RetroCoreLabs/HDLCGW/kicad/HDLC-ESP32-S2/db25-footprint-check.pdf

## DB-25 male, right-angle: footprint check sheet (KiCad 9.0 stock footprints)

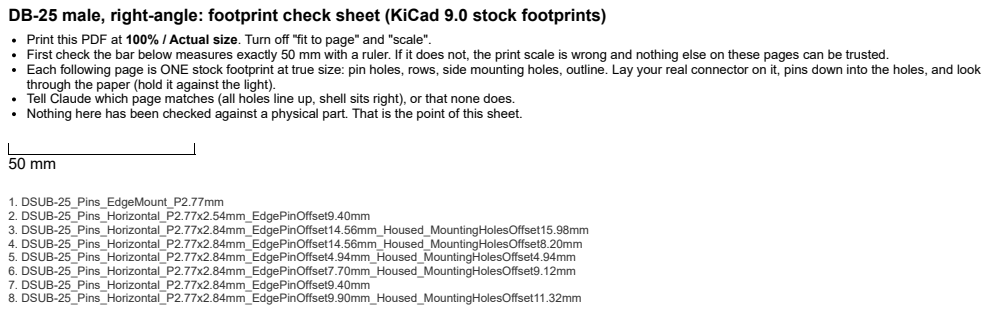
[picture p1: page 1]
1. DSUB-25_Pins_EdgeMount_P2.77mm 2. DSUB-25_Pins_Horizontal_P2.77x2.54mm_EdgePinOffset9.40mm 3. DSUB-25_Pins_Horizontal_P2.77x2.84mm_EdgePinOffset14.56mm_Housed_MountingHolesOffset15.98mm 4. DSUB-25_Pins_Horizontal_P2.77x2.84mm_EdgePinOffset14.56mm_Housed_MountingHolesOffset8.20mm 5. DSUB-25_Pins_Horizontal_P2.77x2.84mm_EdgePinOffset4.94mm_Housed_MountingHolesOffset4.94mm 6. DSUB-25_Pins_Horizontal_P2.77x2.84mm_EdgePinOffset7.70mm_Housed_MountingHolesOffset9.12mm 7. DSUB-25_Pins_Horizontal_P2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

Print this PDF at 100% / Actual size. Turn off "fit to page" and "scale".
First check the bar below measures exactly 50 mm with a ruler. If it does not, the print scale is wrong and nothing else on these pages can be trusted.
Each following page is ONE stock footprint at true size: pin holes, rows, side mounting holes, outline. Lay your real connector on it, pins down into the holes, and look
through the paper (hold it against the light).
Tell Claude which page matches (all holes line up, shell sits right), or that none does.
Nothing here has been checked against a physical part. That is the point of this sheet.

## 1/8 DSUB-25_Pins_EdgeMount_P2.77mm

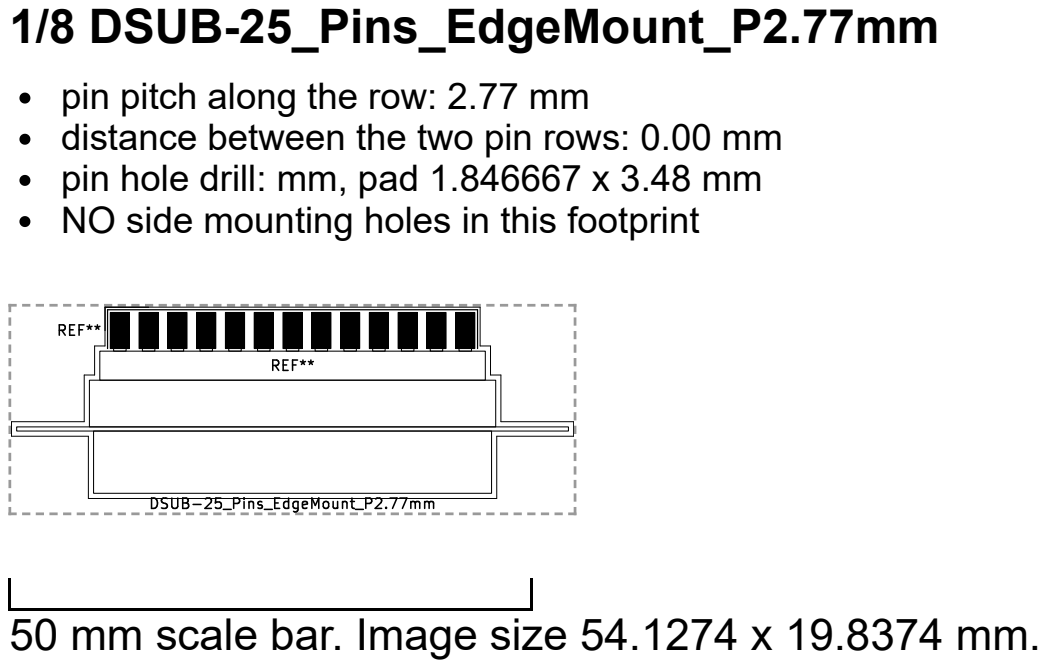
[picture p2: page 2]

pin pitch along the row: 2.77 mm
distance between the two pin rows: 0.00 mm
pin hole drill: mm, pad 1.846667 x 3.48 mm
NO side mounting holes in this footprint

50 mm scale bar. Image size 54.1274 x 19.8374 mm.

## 2/8 DSUB-25_Pins_Horizontal_P2.77x2.54mm_EdgePinOffset9.40mm

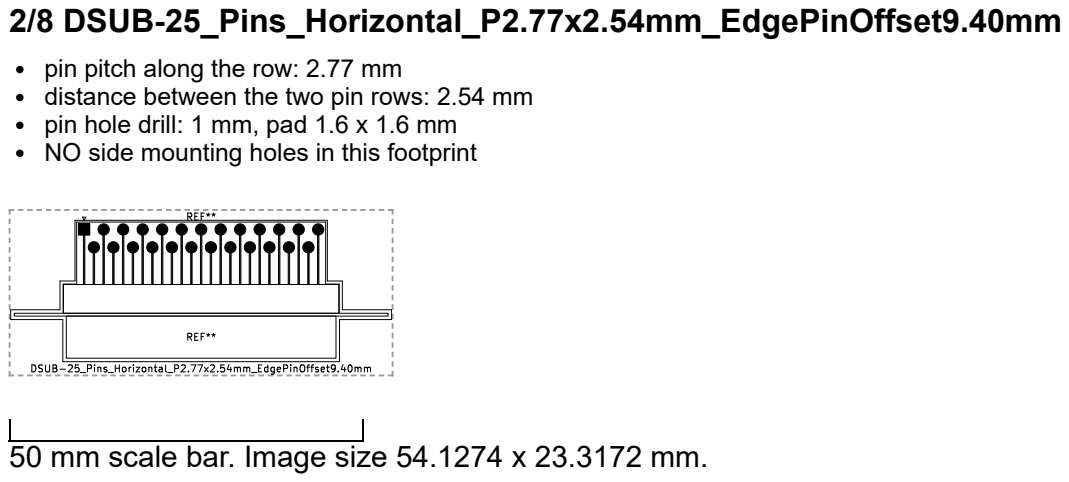
[picture p3: page 3]

pin pitch along the row: 2.77 mm
distance between the two pin rows: 2.54 mm
pin hole drill: 1 mm, pad 1.6 x 1.6 mm
NO side mounting holes in this footprint

50 mm scale bar. Image size 54.1274 x 23.3172 mm.

3/8 DSUB-25_Pins_Horizontal_P2.77x2.84mm_EdgePinOffset14.56mm_Housed_MountingHolesOffset15.98mm

pin pitch along the row: 2.77 mm
distance between the two pin rows: 2.84 mm
pin hole drill: 1 mm, pad 1.6 x 1.6 mm
side mounting holes: 2 holes, centre-to-centre 47.10 mm, drill 3.2 mm, pad 4.0 x 4.0 mm, type thru_hole mounting hole centres sit 1.42 mm from pin row 1 (across the rows)

50 mm scale bar. Image size 78.9432 x 29.7942 mm.

4/8 DSUB-25_Pins_Horizontal_P2.77x2.84mm_EdgePinOffset14.56mm_Housed_MountingHolesOffset8.20mm

pin pitch along the row: 2.77 mm
distance between the two pin rows: 2.84 mm
pin hole drill: 1 mm, pad 1.6 x 1.6 mm
side mounting holes: 2 holes, centre-to-centre 47.10 mm, drill 3.2 mm, pad 4.0 x 4.0 mm, type thru_hole mounting hole centres sit 9.20 mm from pin row 1 (across the rows)

50 mm scale bar. Image size 78.0034 x 29.7942 mm.

5/8 DSUB-25_Pins_Horizontal_P2.77x2.84mm_EdgePinOffset4.94mm_Housed_MountingHolesOffset4.94mm

pin pitch along the row: 2.77 mm
distance between the two pin rows: 2.84 mm
pin hole drill: 1 mm, pad 1.6 x 1.6 mm
side mounting holes: 2 holes, centre-to-centre 47.10 mm, drill 3.2 mm, pad 4.0 x 4.0 mm, type thru_hole mounting hole centres sit 2.84 mm from pin row 1 (across the rows)

50 mm scale bar. Image size 77.0382 x 20.1676 mm.

6/8 DSUB-25_Pins_Horizontal_P2.77x2.84mm_EdgePinOffset7.70mm_Housed_MountingHolesOffset9.12mm

pin pitch along the row: 2.77 mm
distance between the two pin rows: 2.84 mm
pin hole drill: 1 mm, pad 1.6 x 1.6 mm
side mounting holes: 2 holes, centre-to-centre 47.10 mm, drill 3.2 mm, pad 4.0 x 4.0 mm, type thru_hole mounting hole centres sit 1.42 mm from pin row 1 (across the rows)

50 mm scale bar. Image size 77.0382 x 22.9362 mm.

## 7/8 DSUB-25_Pins_Horizontal_P2.77x2.84mm_EdgePinOffset9.40mm

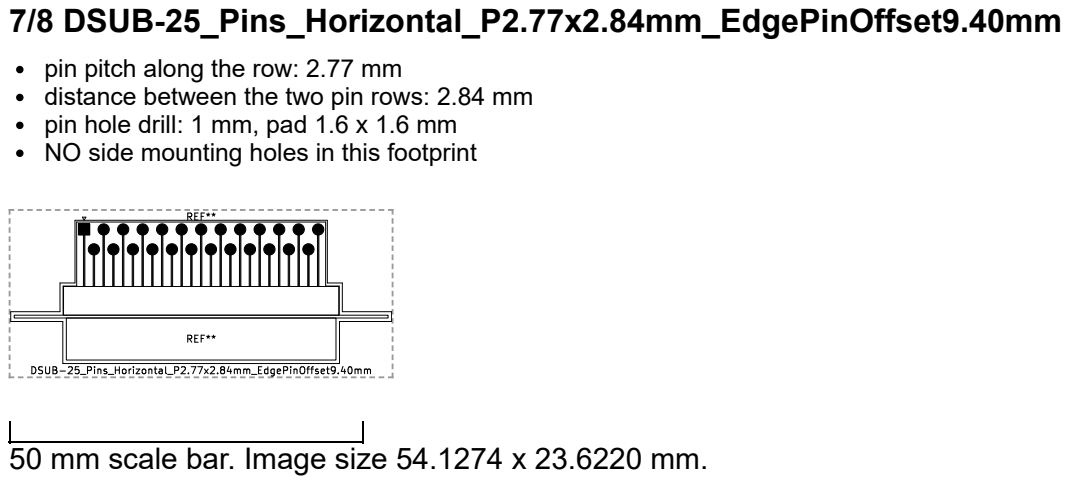
[picture p4: page 8]

pin pitch along the row: 2.77 mm
distance between the two pin rows: 2.84 mm
pin hole drill: 1 mm, pad 1.6 x 1.6 mm
NO side mounting holes in this footprint

50 mm scale bar. Image size 54.1274 x 23.6220 mm.

8/8 DSUB-25_Pins_Horizontal_P2.77x2.84mm_EdgePinOffset9.90mm_Housed_MountingHolesOffset11.32mm

pin pitch along the row: 2.77 mm
distance between the two pin rows: 2.84 mm
pin hole drill: 1 mm, pad 1.6 x 1.6 mm
side mounting holes: 2 holes, centre-to-centre 47.10 mm, drill 3.2 mm, pad 4.0 x 4.0 mm, type thru_hole mounting hole centres sit 1.42 mm from pin row 1 (across the rows)

50 mm scale bar. Image size 78.0034 x 25.1206 mm.
