RetroCoreLabs/HDLCGW/kicad/HDLC-ESP32-S2/wemos-s2-mini-footprint-check.pdf

## WEMOS S2 mini - footprint at 1:1 (print at 100 percent, NOT "fit to page")

Check first: the bar below must measure exactly 50 mm with a ruler. If not, the printer is scaling.

Hold your real board on top of the print and look through the paper. Which end the USB connector is at is NOT verified here: turn the board until the pin holes line up, then tell me which end the USB is at. Each round pad must sit over a pin hole of the board. Pad rows: A and B are the left two columns, C and D the right two columns; pad 1 of each column is at the top.
Pad centres (mm): column A x=0, B x=2.54, C x=20.32, D x=22.86. Row pitch 2.54, 8 rows (y=0 to 17.78). Pad 1 of column A is square.

Outline = board edge from the KiCad C3 mini footprint (about 25.7 x 34.6 mm). This is NOT yet confirmed against your board: that is what this sheet is for. Source: kicad/HDLC-ESP32-S2/HDLC-ESP32-S2.pretty/WEMOS_S2_mini.kicad_mod

50 mm
