RetroCoreLabs/HDLCGW/kicad/HDLC-ESP32-S2/HDLC-ESP32-S2.kicad_sch

## KiCad design kicad/HDLC-ESP32-S2/HDLC-ESP32-S2.kicad_sch (2026-11-12)

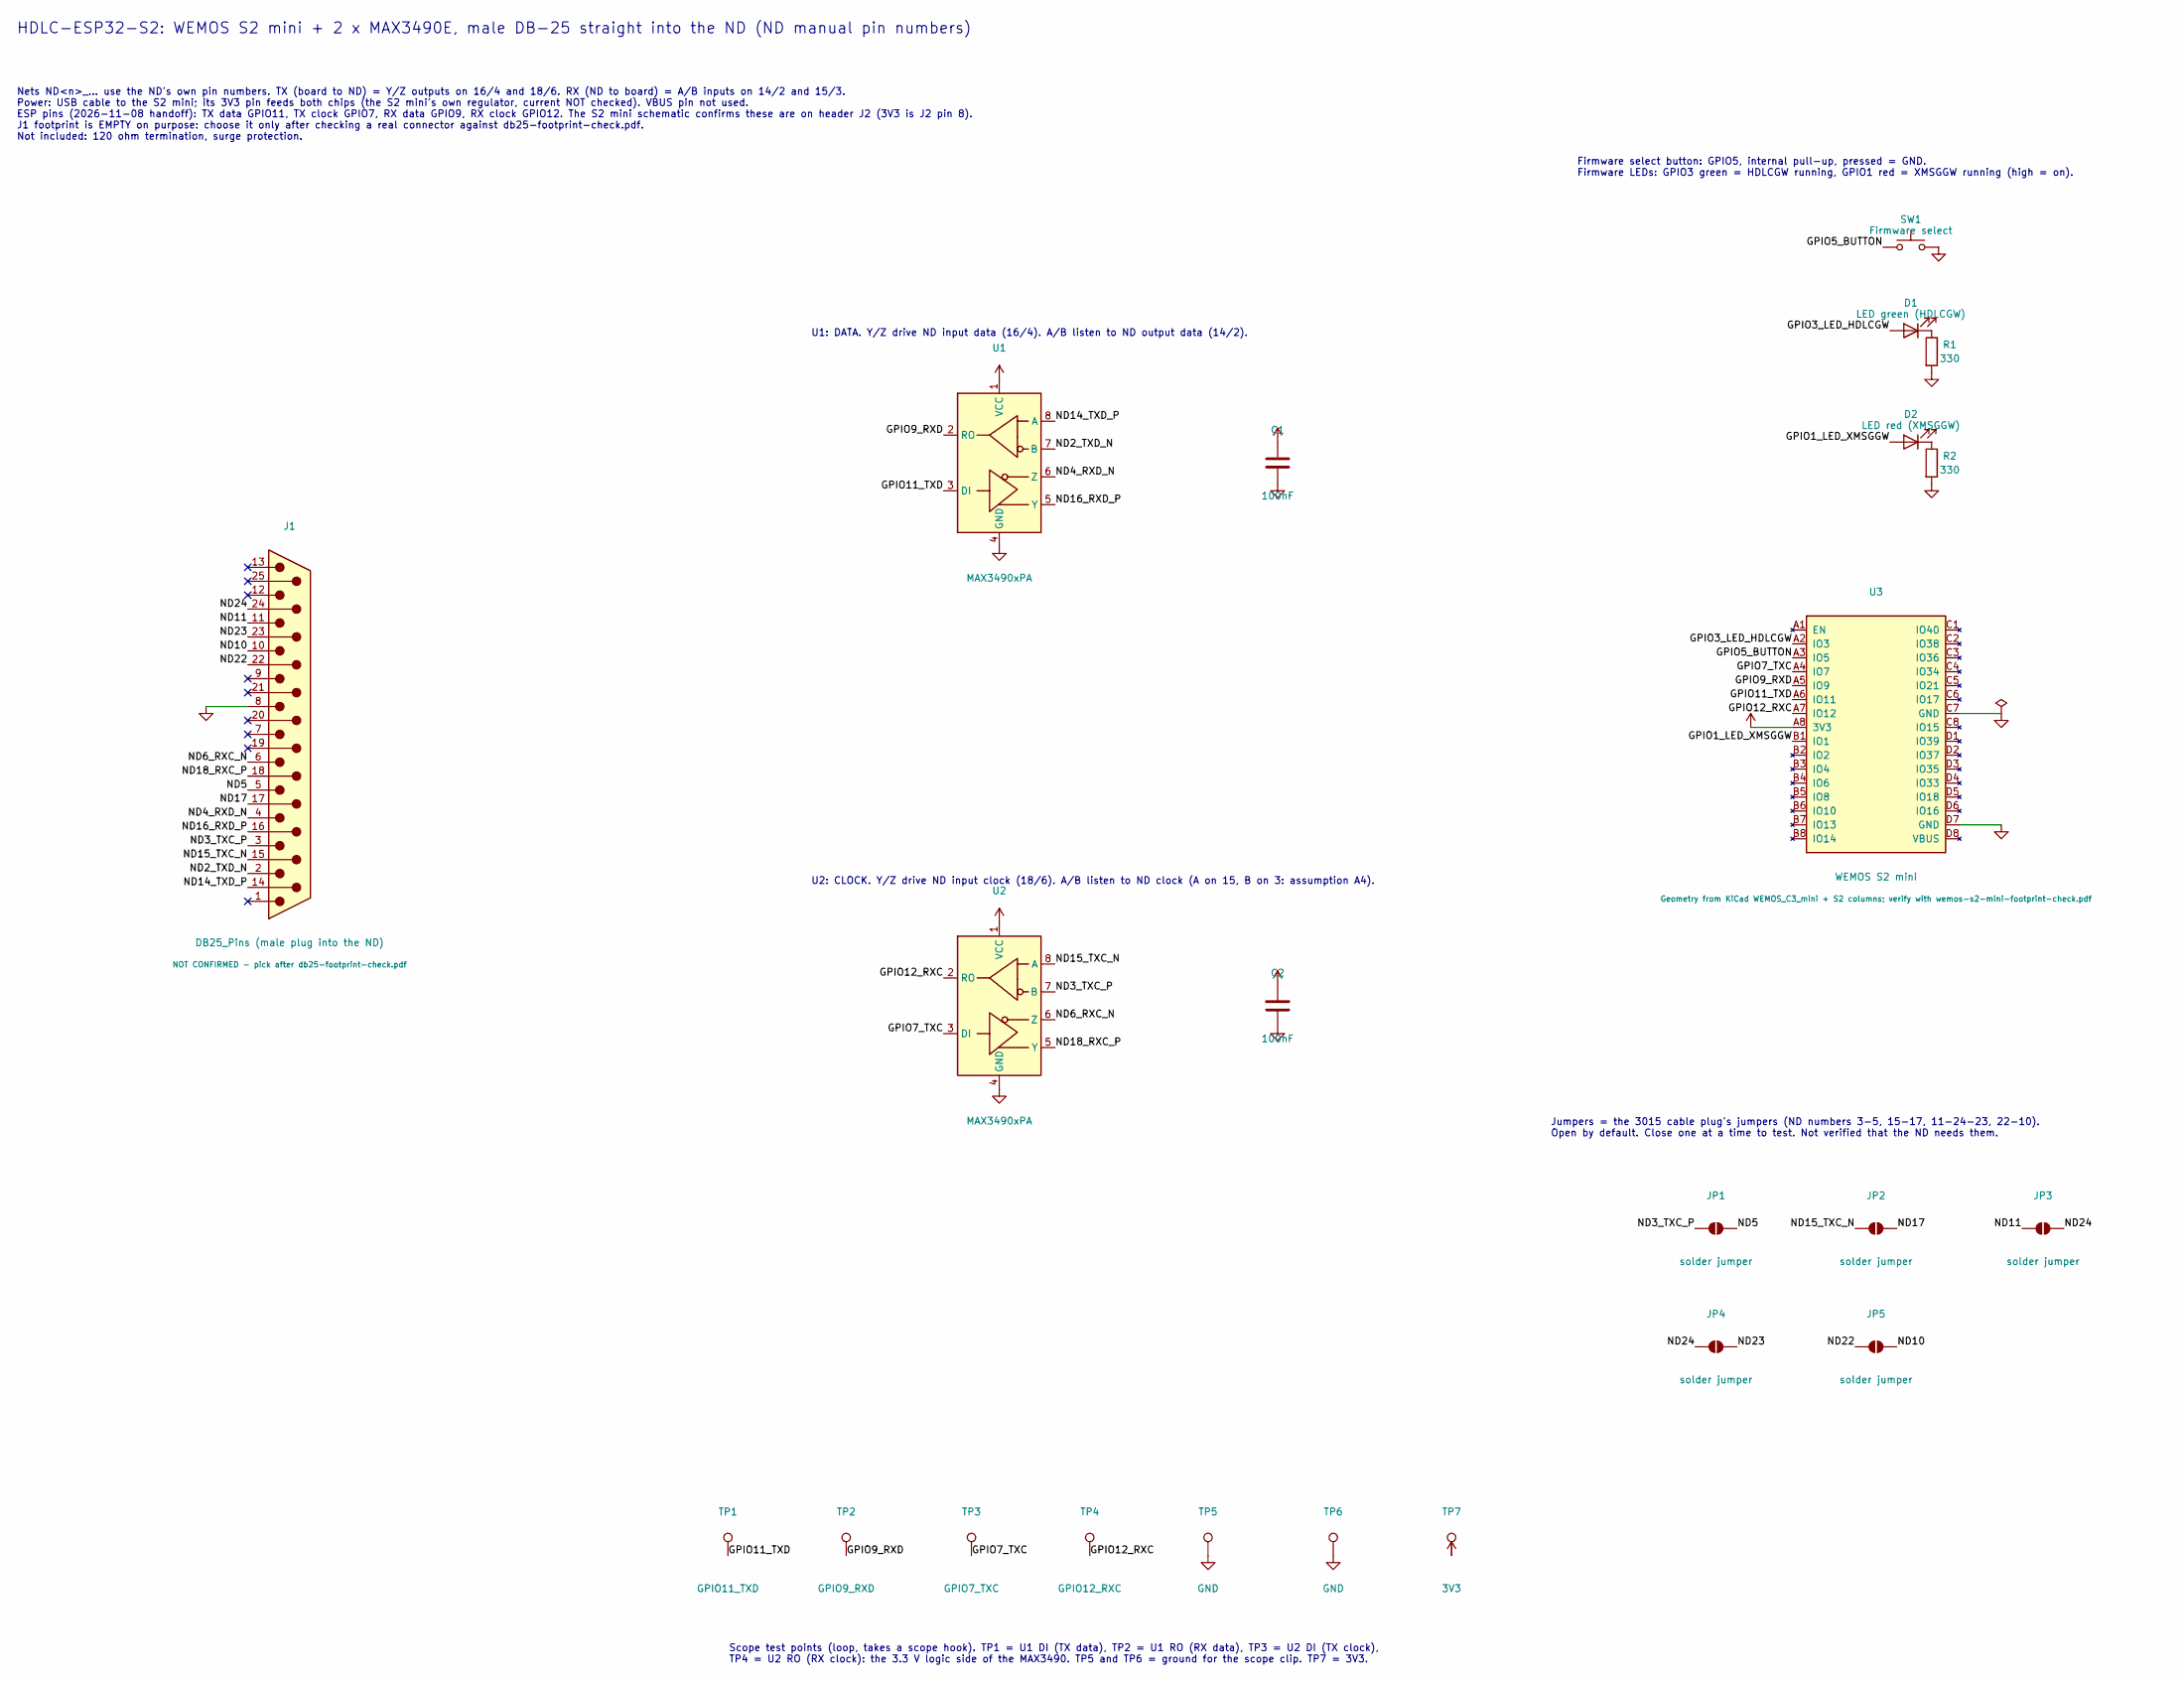
[picture p5: schematic HDLC-ESP32-S2.kicad_sch]

Parts:
C1, C2: 100nF; C_Disc_D5.0mm_W2.5mm_P5.00mm
D1: LED green (HDLCGW); LED_D3.0mm
D2: LED red (XMSGGW); LED_D3.0mm
J1: DB25_Pins (male plug into the ND)
JP1, JP2, JP3, JP4, JP5: solder jumper; SolderJumper-2_P1.3mm_Open_Pad1.0x1.5mm
R1, R2: 330; R_Axial_DIN0207_L6.3mm_D2.5mm_P7.62mm_Horizontal
SW1: Firmware select; SW_PUSH_6mm
TP1: GPIO11_TXD; TestPoint_Loop_D2.50mm_Drill1.0mm
TP2: GPIO9_RXD; TestPoint_Loop_D2.50mm_Drill1.0mm
TP3: GPIO7_TXC; TestPoint_Loop_D2.50mm_Drill1.0mm
TP4: GPIO12_RXC; TestPoint_Loop_D2.50mm_Drill1.0mm
TP5, TP6: GND; TestPoint_Loop_D2.50mm_Drill1.0mm
TP7: 3V3; TestPoint_Loop_D2.50mm_Drill1.0mm
U1, U2: MAX3490xPA; DIP-8_W7.62mm
U3: WEMOS S2 mini; WEMOS_S2_mini

Connections:
+3V3: C1.1, C2.1, TP7.1, U1.1 (VCC), U2.1 (VCC), U3.A8 (3V3)
GND: C1.2, C2.2, J1.8, R1.2, R2.2, SW1.2, TP5.1, TP6.1, U1.4 (GND), U2.4 (GND), U3.C7 (GND), U3.D7 (GND)
GPIO1_LED_XMSGGW: D2.2 (A), U3.B1 (IO1)
GPIO3_LED_HDLCGW: D1.2 (A), U3.A2 (IO3)
GPIO5_BUTTON: SW1.1, U3.A3 (IO5)
GPIO7_TXC: TP3.1, U2.3 (DI), U3.A4 (IO7)
GPIO9_RXD: TP2.1, U1.2 (RO), U3.A5 (IO9)
GPIO11_TXD: TP1.1, U1.3 (DI), U3.A6 (IO11)
GPIO12_RXC: TP4.1, U2.2 (RO), U3.A7 (IO12)
ND2_TXD_N: J1.2, U1.7 (B)
ND3_TXC_P: J1.3, JP1.1 (A), U2.7 (B)
ND4_RXD_N: J1.4, U1.6 (Z)
ND5: J1.5, JP1.2 (B)
ND6_RXC_N: J1.6, U2.6 (Z)
ND10: J1.10, JP5.2 (B)
ND11: J1.11, JP3.1 (A)
ND14_TXD_P: J1.14, U1.8 (A)
ND15_TXC_N: J1.15, JP2.1 (A), U2.8 (A)
ND16_RXD_P: J1.16, U1.5 (Y)
ND17: J1.17, JP2.2 (B)
ND18_RXC_P: J1.18, U2.5 (Y)
ND22: J1.22, JP5.1 (A)
ND23: J1.23, JP4.2 (B)
ND24: J1.24, JP3.2 (B), JP4.1 (A)
unnamed: D1.1 (K), R1.1
unnamed: D2.1 (K), R2.1

Notes on the sheet:
U1: DATA. Y/Z drive ND input data (16/4). A/B listen to ND output data (14/2).
U2: CLOCK. Y/Z drive ND input clock (18/6). A/B listen to ND clock (A on 15, B on 3: assumption A4).
Jumpers = the 3015 cable plug's jumpers (ND numbers 3-5, 15-17, 11-24-23, 22-10). Open by default. Close one at a time to test. Not verified that the ND needs them.
Scope test points (loop, takes a scope hook). TP1 = U1 DI (TX data), TP2 = U1 RO (RX data), TP3 = U2 DI (TX clock), TP4 = U2 RO (RX clock): the 3.3 V logic side of the MAX3490. TP5 and TP6 = ground for the scope clip. TP7 = 3V3.
HDLC-ESP32-S2: WEMOS S2 mini + 2 x MAX3490E, male DB-25 straight into the ND (ND manual pin numbers)
Nets ND<n>_... use the ND's own pin numbers. TX (board to ND) = Y/Z outputs on 16/4 and 18/6. RX (ND to board) = A/B inputs on 14/2 and 15/3. Power: USB cable to the S2 mini; its 3V3 pin feeds both chips (the S2 mini's own regulator, current NOT checked). VBUS pin not used. ESP pins (2026-11-08 han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
Firmware select button: GPIO5, internal pull-up, pressed = GND. Firmware LEDs: GPIO3 green = HDLCGW running, GPIO1 red = XMSGGW running (high = on).
