RetroCoreLabs/HDLCGW/src/XMSGGW/settings.h

/**************************************************************************
** SETTINGS - XMSGGW values kept in NVS across restarts                  **
**                                                                       **
** One NVS namespace, "xmsggw". The node task and the console task both  **
** use it; every call opens and closes its own handle, and ESP-IDF NVS   **
** serialises access itself, so no lock is needed here.                  **
**                                                                       **
** Ronny Hansen                                                          **
** SPDX-License-Identifier: MIT  Copyright (c) 2026 Ronny Hansen         **
***************************************************************************/
#ifndef SETTINGS_H
#define SETTINGS_H

#include <stdbool.h>
#include <stddef.h>
#include <stdint.h>

/* The line rate and the WiFi network are shared with HDLCGW: ../common/board.h. */

/**
 * @brief Our LAPB node number.
 * @return The stored number, or 0 when none has been set (NODE command).
 *         The gateway does not start the link without one: there is no
 *         number it could safely guess.
 */
uint16_t settings_node(void);

/**
 * @brief Store our LAPB node number. Used from the next restart.
 * @param[in] node  1..65535.
 * @return 0 on success, -1 when the NVS write failed.
 */
int settings_set_node(uint16_t node);

/**
 * @brief Flags1 counter for one peer machine (libxmsg XmsgFlags1Port.load).
 * @return 0 and *next filled when stored, -1 otherwise.
 */
int settings_flags1_load(void *ctx, uint16_t peer_node, uint16_t *next);

/** @brief Store the Flags1 counter for one peer (XmsgFlags1Port.save). @return 0 or -1. */
int settings_flags1_save(void *ctx, uint16_t peer_node, uint16_t next);

/** @brief Port-word seed (XmsgFlags1Port.load_port_seed). @return 0 when stored, -1 otherwise. */
int settings_port_seed_load(void *ctx, uint16_t *seed);

/** @brief Store the port-word seed (XmsgFlags1Port.save_port_seed). @return 0 or -1. */
int settings_port_seed_save(void *ctx, uint16_t seed);

/**
 * @brief Terminal type sent in each terminal session's setup (TAD TTYP).
 *
 * SINTRAN copies these two bytes straight into the host's terminal type (the
 * J driver's BDTTYP, tad_asker.h). Every real asker in the captures sends 0,
 * so 0 is the default. Lead from the libxmsg session, not proven: a TDV
 * HELP key (ESC [ 4 6 _) got BEL over TAD, but worked on a direct terminal
 * of type 93.
 *
 * @return The stored type, 0 when none is stored.
 */
uint16_t settings_ttyp(void);

/**
 * @brief Store the terminal type; used for sessions opened after this.
 * @param[in] ttyp  0..65535.
 * @return 0 or -1.
 */
int settings_set_ttyp(uint16_t ttyp);

/**
 * @brief Whether typed bytes go to the host with even parity in bit 7
 *        (libxmsg TadAskerConfig.keystroke_parity).
 *
 * libxmsg sets it by default because captured TAD sessions of typed text
 * carry it. A TDV function key sent that way (SLUTT, 1B DB B4 B8 5F) was
 * answered with BEL by S3-CONFIG, while the same key without parity on
 * D100's own terminal port worked (Ronny, 2026-11-10 11:36 and 11:37).
 * Whether parity is the cause is not proven; this setting is the test.
 *
 * @return true (the default) when parity is added.
 */
bool settings_parity(void);

/** @brief Store the keystroke parity choice; used for sessions opened after this. @return 0 or -1. */
int settings_set_parity(bool on);

/**
 * @brief Aliases: names a user may give CONNECT in place of a system number.
 *
 * A name such as "D100" is only an alias someone set up on SINTRAN; nothing
 * about the name gives the number (Ronny, 2026-11-10), so XMSGGW keeps its
 * own list, set by hand (USB console ALIAS). How SINTRAN's CONNECT-TO gets
 * the synonyms it shows in LIST-SYSTEM is not known yet. Kept in one NVS
 * string, "name=number" lines, key "alias".
 */
#define SETTINGS_ALIAS_NAME_MAX 15
#define SETTINGS_ALIAS_MAX 32

/**
 * @brief Look an alias up (case ignored).
 * @return 0 and *system filled, or -1 when not in the list.
 */
int settings_alias(const char *name, uint16_t *system);

/**
 * @brief Add an alias, or change its number.
 * @return 0; -1 for a bad name (empty, too long, or only digits), a full list or a failed write.
 */
int settings_alias_set(const char *name, uint16_t system);

/** @brief Remove an alias. @return 0, or -1 when not in the list or the write failed. */
int settings_alias_delete(const char *name);

/**
 * @brief The list as text, one "name  number" line each, CR LF ended.
 * @return The count.
 */
int settings_alias_list(char *out, size_t size);

#endif /* SETTINGS_H */
