RetroCoreLabs/HDLCGW/(commit log)

2026-11-09 Rewrite: SPI line tasks, RFC 1662 host framing, control frames, WiFi/TCP
    Replaces the GPIO-interrupt receiver with a two-clock design: SPI2 master
    transmits and generates the transmit clock, SPI3 register-level slave with
    a circular DMA ring receives on the far end's clock. HDLC bit stuffing,
    flag/abort detection and FCS in software (hdlc.cpp). The host side speaks
    RFC 1662 byte-stuffed frames like RC422Dev, with 0xFE control frames for
    commands, replies, log, counters and events, and a text console.
    WiFi station with a TCP server/client carrying the same frames
    (nd100x dials hdlcgw.local:1362). Received WiFi frames are copied out of
    the driver's buffer so lwIP's out-of-order queue cannot h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
    [HDLCGW.ino, commands.cpp, commands.h, console_out.cpp, console_out.h, console_task.cpp, console_task.h, wifi_task.cpp]
2026-11-09 Use libhdlc for the line, host and control framing
    hdlc, byte_frame, control_frame, ring_buffer and hot_path moved into the
    libhdlc Arduino library (libhdlc a2ccf75), shared with RC422Dev. The
    sketch includes <libhdlc.h> first so arduino-cli finds the library.
    The line sink now gets a frame status: CRC errors still log "FCS BAD"
    (the PC tool filters on it); the new ODD_BITS and TOO_LONG cases log by
    name. Short frames are read from the decoder's stats.
    Full two-board sweep on this build (HELLO 14:32:50) against RC422Dev:
    376 pass, 0 fail, all four rates, sizes 10 to 626, no lost or bad frames.
    [HDLCGW.ino, commands.cpp, console_out.h, console_task.cpp, wifi_task.cpp]
2026-11-09 Use the SPI line tasks from libhdlc
    spi_rx_task and spi_tx_task now live in libhdlc (src/libhdlc/esp32s2/,
    commit f001655). Their text goes through line_log: start-up errors
    straight to USB serial, then to the console log once it is up; RXDMA
    passes a print function.
    Two-board sweep on this build (17:41:14) against RC422Dev: 376 PASS,
    0 FAIL, ODD_BITS 0, TOO_LONG 0, FCS BAD 0, 19200 to 983000 bit/s; worst
    receive gap 1297 us, no FIFO overrun, DMA error or ring overflow.
    [HDLCGW.ino, commands.cpp, console_out.cpp, console_task.cpp, wifi_task.cpp]
2026-11-09 Name the decoder's new per-frame callback as unused
    hdlc_frame_sink gained an on_frame field (libhdlc faecb7c, per-frame
    receive mode). HDLCGW stays in per-byte mode, so the sink sets it to
    NULL explicitly instead of leaving it to the zero default.
    Two-board sweep on this build (Nov 9 17:47:01, log
    fullrun-20261109-180915) against RC422Dev: 376 PASS, 0 FAIL, FCS BAD 0,
    no FIFO overrun, DMA error, ring overflow or gap over 20 ms.
    [console_task.cpp]
2026-11-09 XMSGGW: XMSG node on the ESP32-S2 with HDLCGW's task and console layout
    The libxmsg node runs in its own task over the libhdlc SPI line tasks and
    the per-frame decoder. The USB port works as in HDLCGW: control frames
    (HELLO, COMMAND, LOG_LEVEL, STAT_PUSH, PING) and a text console after ESC
    ESC ESC. Commands: HELP, STAT, NODE, LINK, BAUD, CLOCK, INSPECT [BAD n],
    LOG, TASK, INFO, RESET, EXIT.
    First run 2026-11-09 as node 101 through the RC422Dev bridge to the D100
    emulator: LAPB up, peer 100 learned, resync done, one datagram in,
    0 bad frames.
    [XMSGGW.ino, commands.cpp, commands.h, console_out.cpp, console_out.h, console_task.cpp, console_task.h, node_task.cpp]
2026-11-09 XMSGGW: REACH command, and count only reachability requests that are sent
    REACH asks the peer "are you there?" (XMSG subtype 0x19), the same request
    sent at every link-up; STAT shows requests sent, answers, and requests from
    the peer. libxmsg sends nothing while an earlier request waits for its
    answer, so the counter now counts only calls made with none waiting.
    Bench 2026-11-09, node 101 to D100 through the RC422Dev bridge: three
    REACH at 20:08:40 put one request on the line (the bridge frame log shows
    two 0x19 requests and two 0x13 replies from 20:08:15 on); after the fix,
    3 sent and 3 answered, 0 bad frames.
    [commands.cpp, node_task.cpp, node_task.h]
2026-11-09 XMSGGW: TERM command, a terminal session to a SINTRAN host
    TERM CONNECT <system> opens a TAD session (libxmsg tad_asker) from the node
    task; TERM TYPE queues a line, TERM SHOW prints the host text, TERM STATUS
    and TERM HANGUP. The asker runs in the node task; text crosses to the
    console through two small locked buffers. A host logout hangs up.
    Bench 2026-11-09, node 101 to D100 through the RC422Dev bridge: banner and
    ENTER prompt, login as SYSTEM, WHO-IS-ON listed four terminals, LOGOUT gave
    --EXIT-- and the session closed with error 0. 257 bytes of host text, 0
    lost; 71 frames sent, 53 received, 0 bad.
    [commands.cpp, node_task.cpp, node_task.h]
2026-11-09 XMSGGW: WiFi and a telnet server for 8 users, each with its own terminal session
    telnet_task joins the stored WiFi network and listens on port 23 for up to
    8 users at once (Ronny: at least 8); a 9th is turned away. Each user gets
    its own TAD session in term.cpp, a pool of 9 (8 telnet, 1 for TERM) run by
    the node task. build_opt.h raises XMSG_MAX_SESSIONS to 12. The XMSG node
    and the session pool moved to PSRAM: with WiFi linked in, internal RAM
    overflowed by 4,080 bytes. WIFI command shows the state and stores a
    network (password never printed); with none of its own it reads HDLCGW's.
    Bench 2026-11-09, node 101 to D100 through the RC422Dev bridge, WiFi
    192.168.1.136: 8 telnet users at once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
2026-11-09 XMSGGW: ESC key as a TAD escape, no echo of Enter, TTYP setting
    A lone ESC (nothing after it within 50 ms, libxmsg term_escape) now goes
    to the host as an ESCA, which breaks the running program; an ESC that
    starts a function key goes through as text, as libxmsg host_tad_telnet.c
    does. Enter is no longer echoed: the host sends its own CR LF for it, so
    every Enter gave two new lines (Ronny's log, 2026-11-09 23:37:39).
    TTYP stores the terminal type sent at session setup (default 0, what real
    askers send); a lead from the libxmsg session, not proven, is that the TDV
    HELP key needs type 93.
    [commands.cpp, settings.cpp, settings.h, telnet_task.cpp, term.cpp, term.h]
2026-11-09 Telnet login and the XMSGGW command line
    Telnet users now log in to XMSGGW (libxmsg auth_login, PBKDF2-SHA256 through
    mbedTLS, user list in NVS "xmsgusr"; the first boot writes the default admin,
    which must change its password) and get the "XMSGGW> " prompt: CONNECT
    <system>, LIST (not implemented yet), WHO, INFO, PASSWORD, HELP, EXIT, and for
    admins USERS, ADDUSER, DELUSER, RESETPW. A session that ends returns the user
    to the prompt instead of closing the connection.
    Tested on the board against D100: login with forced password change, INFO,
    WHO, HELP, CONNECT D100, SINTRAN login and LOGOUT (session closed, error 0,
    back at the prompt), EXIT. One password check takes 22.8 s at 100000
    iterat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
    [telnet_task.cpp, telnet_task.h, users.cpp, users.h]
2026-11-10 Password hash at 2000 rounds instead of 100000
    100000 PBKDF2 rounds took 22810 ms per check on the ESP32-S2 and stopped every
    other telnet user meanwhile. New records use 2000; a login of a record with
    another count stores it again at 2000 from the password just typed, since a
    password change keeps the record's own count.
    Tested on the board: the first login re-stored the 100000-round admin (24 s),
    the next login took 484 ms; USERS and INFO correct.
    [telnet_task.cpp, users.cpp, users.h]
2026-11-10 README: telnet login, command line, console commands and current state
2026-11-10 LIST reads the host's routing table; XMSGGW user name to SINTRAN; no [ ] in text
    - LIST at the XMSGGW> prompt asks the host (D100) for its whole routing
    table (libxmsg xrout_walk) and shows every entry; the walk runs in the node
    task (route_list.cpp), the prompt returns when it ends. Not yet tried live.
    - The TAD session carries the XMSGGW user as "<user>@xmsggw" when that fits
    the 16 characters TAD allows, else the name alone; the console session
    keeps libxmsg's "REMOTE".
    - No [ ] in text to a user (a TDV in Norwegian 7-bit shows them as letters);
    the session end line shows the error number only when it is not 0.
    Built against libxmsg 5e17319, which answers the host's routing que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
    [commands.cpp, node_task.cpp, telnet_task.cpp, term.cpp, term.h]
2026-11-10 Use libxmsg's shared console for telnet and SINTRAN callers
    The login, the XMSGGW> command line and CONNECT-TO D101 callers now run
    on libxmsg console/console.h, console_tad.h and term_telnet.h instead of
    our own copies. telnet_task keeps WiFi and the per-connection queues;
    gw_console.cpp plugs in the services (onward sessions on term.cpp slots,
    LIST and NAMES walks, INFO, NODE and RESTART for admins). tad_in and
    route_list are gone.
    Tested on the board through telnet and from D100: login, HELP, LIST,
    NAMES, INFO, WHO, CONNECT D100 with S3-CONFIG SLUTT and help keys,
    CONNECT-TO D101, LI-SYS, USERS, ADDUSER, DELUSER.
2026-11-10 INFO shows the line rate the line really runs at
    INFO read the stored rate setting, which is 0 when none was ever
    stored, and printed "Speed: not known" while the line ran at the
    38400 default. It now reads the transmit task's running rate.
    Checked on the board: "Speed: 307200 bits per second".
2026-11-10 Move the HDLCGW sketch into src/HDLCGW, datasheets into docs/
    First step of one repository for the ESP32-S2 gateway board: the
    sketches go under src/ (HDLCGW now, XMSGGW next), the board drawing
    and its notes under kicad/ and docs/. The .gitignore now names the
    Doxygen output folder exactly (src/HDLCGW/docs/), so the top-level
    docs/ folder is kept, and ignores KiCad's backup folders.
2026-11-10 Top-level README: the board, the two sketches, kicad/ and docs/
2026-11-10 Add the board schematic (kicad/) and its wiring notes (docs/)
    The HDLC-ESP32-S2 schematic: WEMOS S2 Mini, two MAX3490E (data and
    clock pairs), male DB-25 into the ND machine, scope test points and
    solder-jumper straps. Schematic only; no PCB layout yet, and the DB-25
    footprint is left empty until it is checked against the real
    connector. Moved from the Pico firmware repository, where it was never
    committed. KiCad's per-user view settings (*.kicad_prl) and backup
    folders are not kept.
    [HDLC-ESP32-S2.kicad_sch]
2026-11-10 Pin libxmsg (with libhdlc inside it) at f07e9d4
    libhdlc moved into the libxmsg repository (src/libhdlc), so one
    submodule now holds both libraries the sketches use. src/external/
    libxmsg is that repository at f07e9d4, the commit that finished the
    move. Every HDLCGW commit now records the library version it goes
    with.
2026-11-10 XMSGGW: NAMES <system>; libxmsg pinned at 7c36c07
    libxmsg 7c36c07 lets NAMES take a system, as a number or an alias
    resolved the same way CONNECT resolves one, and refuses CONNECT or
    NAMES to the gateway's own system before anything starts. The NAMES
    hook now carries that system: 0 is plain NAMES (the linked host, as
    before), anything else is the system whose names are asked, through
    our link neighbour. Whether a SINTRAN host answers for a system that
    is not its own is not verified yet.
    [gw_console.cpp]
2026-11-10 kicad: DB-25 footprint print check, notes and todo list
    The last file of the board drawing (the DB-25 footprint check print),
    held back while it was open, plus the KiCad session's working notes
    and open items for the schematic.
2026-11-10 Root README: what the board is, links to each folder's README
    kicad/NOTES.md becomes kicad/README.md so the folder has a front page.
2026-11-10 XMSGGW: NAMES <system> addresses the question to that system
    The names question now carries the asked system's number both as the
    header's destination node and as the XROUT system, so the neighbour
    relays it on - the way SINTRAN's own XMSG-COMMAND LIST-NAMES does
    (captured: D102 asking D101 through D100). Sending it to the neighbour
    with the far system only in the sub-header made D100 refuse it (XEIMA).
    Tested live: NAMES 102 and NAMES D102 list D102's 13 names through
    D100; plain NAMES still lists D100's.
2026-11-11 XMSGGW: FTP downloads and active mode
    RETR reads a SINTRAN file through libcosmos' COSMOS file client (libxmsg
    93387b4). The node task runs the client and the bytes land in a 1 MB PSRAM
    buffer that the FTP side sends from while they arrive (file_fetch). NAME.TYPE
    in FTP is NAME:TYPE in SINTRAN; a refusal gives 550 with SINTRAN's error.
    Active mode: PORT and EPRT, only back to the client's own address.
    SIZE and MDTM now answer 502, not 550: curl took 550 as "no such file".
    Tested with curl (passive, active), tnftp and Windows ftp.exe: 255, 5035 and
    6835 bytes, the sizes FILE-STATISTICS gives, from D100 and from D102 through
    D100.
    [ftp_server.cpp, ftp_server.h, node_task.cpp]
2026-11-11 XMSGGW: escape stops SINTRAN; FILE-STAT without a file; full user names
    Escape during LIST-FILES, FILE-STAT or COPY-TERM, or the user leaving,
    now stops the file client (fa_client_cancel, libxmsg 96bf7ee), so SINTRAN
    stops too and the next command starts at once. An FTP user who aborts or
    leaves stops it the same way.
    FILE-STAT with no file shows every file, as LIST-FILES does. Lines show
    SINTRAN's full user name from its directory answer (SYST typed shows
    SYSTEM, as SINTRAN prints it).
    A capture of SINTRAN's own LIST-FILES from D100 to D102 shows the request
    carries "(USER)FILTER'" exactly as typed and the remote does the matching;
    the gateway sends the same, checked with :MODE, a C prefi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
2026-11-12 XMSGGW: FILE-STAT prints the access lines in SINTRAN's words
    The access word was shown as raw octal. It holds three groups of five
    bits (PUBLIC 10-14, FRIEND 5-9, OWN 0-4; R W A C D from bit 0), and is
    now printed as SINTRAN's FILE-STATISTICS does, for example
    FRIEND ACCESS : READ, WRITE, APPEND, COMMON, DIRECTORY, or NONE.
    Checked against D100's own FILE-STAT of STARTX3:MODE (access 003777).
2026-11-12 Documentation site for GitHub Pages
    MkDocs Material, the same setup as libxmsg's site. src/tools/gen_docs.py
    writes the pages into build-site/ (not tracked): one reference page per
    header of the HDLCGW and XMSGGW sketches, made from their comments, an
    index of every call, and the READMEs and hardware notes as guides.
    src/docs-site holds the settings, the link hook and the styles; the
    logo is src/assets/hdlcgw.svg. The Docs workflow builds with --strict
    and publishes on every push to master.
2026-11-12 XMSGGW: one file-job module for FTP and the console file commands
    The FTP server (file_fetch) and LIST-FILES / FILE-STAT / COPY-TERM
    (file_console) each had their own copy of the code that runs libcosmos'
    COSMOS file client: callbacks, buffers, cancel and error text. Both now
    use file_job: the node task runs every job, each front end owns one job
    so both can still work at the same time, and what SINTRAN sends streams
    through two rings the front end takes from.
    FTP downloads stream instead of being held whole, so the 1 MB limit is
    gone (256 KB ring; a client that falls that far behind fails the
    transfer rather than get a broken file).
    Tested on the board: FTP listing (253 files), NLST CHAT*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
    [file_console.cpp, file_job.cpp, file_job.h, ftp_server.cpp, ftp_server.h, node_task.cpp]
2026-11-12 XMSGGW: FTP upload, SINTRAN-style listings, libxmsg 031ed9c
    - STOR writes a file to SINTRAN (up to 1 MB). TYPE A adds even parity
    in bit 7 on the way in; TYPE I stores the bytes unchanged. An existing
    file is refused with SINTRAN error 62 and left as it was.
    - The shared file job can now write (file_job_start_write).
    - LIST NAME / NLST NAME pass the name to SINTRAN as a filter, as
    SINTRAN's own FTP server does.
    - ls -l lines show the owner, the SINTRAN access letters and the page
    count. SITE TABLE switches to SINTRAN's own table (file number, access,
    pages, bytes, date). CONV switches names between NAME.TYPE and
    NAME:TYPE;version. HELP lists all of it.
    - The idle timer no longer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
    [file_console.cpp, file_job.cpp, file_job.h, ftp_server.cpp]
2026-11-12 XMSGGW: FTP upload replaces a file that exists; libxmsg d984aa4
    STOR first asks SINTRAN for a new file. When SINTRAN answers error 62
    (the file exists, left as it was), the gateway asks again to write over
    it. Tested on D100 with 2000, 3000 and then 500 bytes: each read back
    unchanged, and FILE-STATISTICS showed 500 bytes after the last one.
    The file job takes the write mode; libxmsg d984aa4 adds it to
    fa_client_write. The table listing's number column is now 4 wide, as in
    SINTRAN's own FTP server.
    [file_job.cpp, file_job.h, ftp_server.cpp]
2026-11-12 XMSGGW: table number column back to 3 wide; README corrections
    SINTRAN's own FTP server prints the file number 3 wide ("100 rwac...",
    " 73 rwac..."), measured on its live listing. The 4-wide column in the
    last commit was not measured and was wrong.
    README: SITE TABLE is the gateway's own switch (SINTRAN's server always
    prints the table and knows no SITE); SINTRAN's server cannot run a
    command over FTP (checked on its program and on a live server); it does
    delete files with DELE, which the gateway does not do yet.
    [ftp_server.cpp]
2026-11-12 XMSGGW: INFO shows who is on FTP and the FTP counters
    INFO now has "FTP: <user> from <address>, on for N s" (or "nobody
    on") and the counts since start: connections, turned away, logins,
    wrong logins, listings, files. INFO runs in the node task and the FTP
    server in the telnet task, so the server keeps who is on in a small
    record under a lock and INFO copies it. Tested on the board with an FTP
    login held open, and again after it left.
    WHO still lists console sessions only: it is built in libxmsg's shared
    console, which has no hook for other users yet (asked for).
    [ftp_server.cpp, ftp_server.h, gw_console.cpp]
2026-11-12 XMSGGW: WHO shows the FTP user; libxmsg 54f820c
    WHO now ends with a line for a connected FTP user, in the same columns
    as the telnet sessions: FTP, the user, the address, how long, FTP. It
    comes through libxmsg's new who_more hook. Tested on the board with an
    FTP login held open beside a telnet session.
    libxmsg 54f820c: the who_more hook; also c46e52e and ec60071 (notes from
    the file-number and shorter-overwrite measurements).
    [gw_console.cpp]
2026-11-12 Docs site: Material 9.7.7 and pymdown-extensions 11.0.2 (security fixes)
    Closes GitHub's three alerts on the site's build tools: a search-box
    script injection in Material (fixed in 9.7.7), and in
    pymdown-extensions a pattern that can hang the build and a file read
    outside its folder (fixed in 11.0.1 and 11.0.0). The strict site build
    passes with no warnings on the new versions.
2026-11-12 Board: firmware select button and two firmware LEDs
    For the two firmwares in one board (HDLCGW in slot 1, XMSGGW in slot 2):
    - SW1 push button from GPIO5 to GND; the firmware uses the internal
    pull-up, so no resistor. GPIO5 is not a strapping pin.
    - D1 green on GPIO3 (HDLCGW running) and D2 red on GPIO1 (XMSGGW
    running), each through 330 ohm to GND, lit when the pin is high.
    - IO1, IO3 and IO5 in the WEMOS symbol are now bidirectional pins.
    ERC: 0 errors, the same 2 old MAX3490 library warnings. Nets checked
    in the exported netlist. Layout is not done (there is no PCB file).
    [HDLC-ESP32-S2.kicad_sch]
2026-11-12 Two firmwares on one board: switching, going back, shared settings
    HDLCGW lives in slot 1 (0x10000) and XMSGGW in slot 2 (0x150000).
    The shared code is in src/common (board.h); each sketch pulls it in
    with a one-line board.cpp.
    - FIRMWARE shows both slots; FIRMWARE SWITCH restarts into the other
    one (USB console of both, XMSGGW telnet for the admin). A button on
    GPIO5 held at start does the same; GPIO3 green / GPIO1 red light for
    the firmware that runs.
    - A switched-to firmware is on trial for 10 s; a restart in that time
    sends the board back (bootloader rollback, verifyRollbackLater()).
    - WiFi network and line rate are shared (NVS namespace "board"),
    copied once from the old per-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
2026-11-12 Build both firmwares in GitHub Actions; a v* tag makes the release
    arduino-cli 1.5.1, ESP32 core 3.3.12, libxmsg from the submodule. The
    files get the names docs/INSTALL.md uses, plus full.bin (merge-bin).
    A tag also starts the docs workflow on master so the flash page gets
    the new files.
2026-11-12 Firmware workflow: full.bin keeps each file's own flash settings
    As the Arduino build makes its merged image (--flash-mode/freq/size
    keep), instead of values typed into the workflow.
2026-11-12 WIFI SCAN in both firmwares, WIFI SHOW for the password on USB
    The network list moves to shared code (board_wifi_scan), so XMSGGW gets
    the WIFI SCAN HDLCGW had. WIFI SHOW prints the stored network name and
    password; both firmwares run WIFI commands from the USB console only, so
    telnet and TCP cannot read it.
2026-11-12 XMSGGW: one command list for the USB and telnet consoles
    The USB text console (three ESC) is now a place of the same console a
    telnet user gets, logged in as admin with no password: WHO, LIST, NAMES,
    CONNECT and the file commands work on USB. The USB console's own commands
    (STAT, BAUD, WIFI, INSPECT, ...) work on telnet by user rights: STAT,
    INSPECT, TASK and WIFI [STATUS|SCAN] for everybody, the rest for the
    admin, TERM and WIFI SHOW on USB only. They run in the USB task with their
    text caught, so WIFI SCAN (about 3 s) does not stop the node task that
    keeps the link. The bad-frame history moves to PSRAM: internal RAM ran
    over by 1120 bytes.
    Tested on the board over USB: WHO, STAT, WIFI SCA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
2026-11-13 XMSGGW: HELP <command>, TAB completion, USB prompt XMSG#
    libxmsg moved to 52960c2 (console: HELP <command>, TAB completion of the
    command word, a prompt per line). XMSGGW gives the core one command
    table: the file commands (their examples move from plain HELP to HELP
    LIST-FILES, HELP FILE-STAT and HELP COPY-TERM), NODE, RESTART, FIRMWARE,
    SINTRAN, and the shared USB commands, whose 'usage - text' help becomes
    the summary and the detail. The USB console's prompt is XMSG# again,
    telnet stays XMSG>.
    Built with 0 warnings (HDLCGW too); not yet run on the board.
